ChrGri/DIY-Sim-Racing-FFB-BeltTensioner/docs/media/youtube_thumbnail_1.jpg

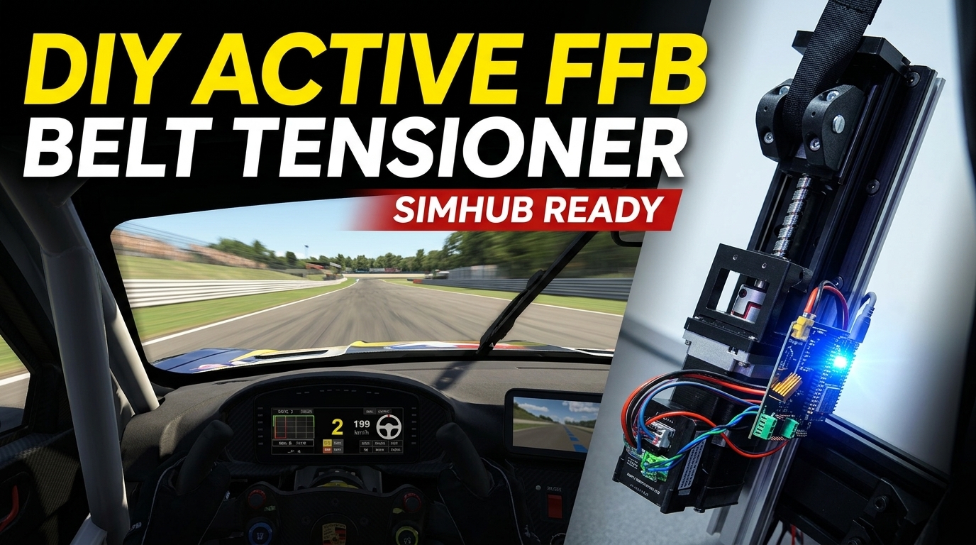
docs/media/youtube_thumbnail_1.jpg
