ChrGri/DIY-Sim-Racing-FFB-BeltTensioner/docs/media/youtube_thumbnail_2.jpg

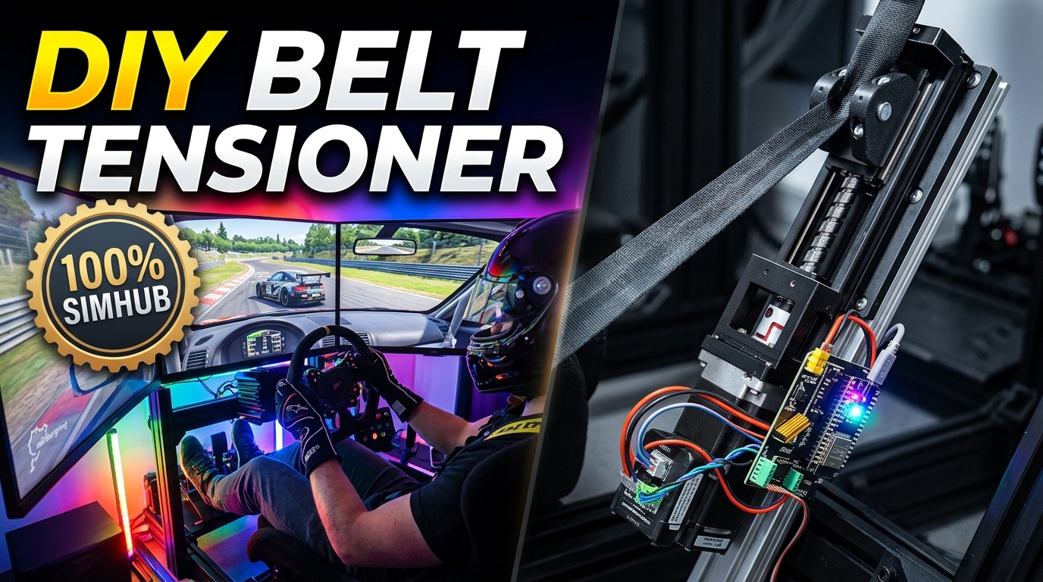
docs/media/youtube_thumbnail_2.jpg
