ChrGri/DIY-Sim-Racing-FFB-BeltTensioner/cad/models/ControlBoard_PCB_V8.step

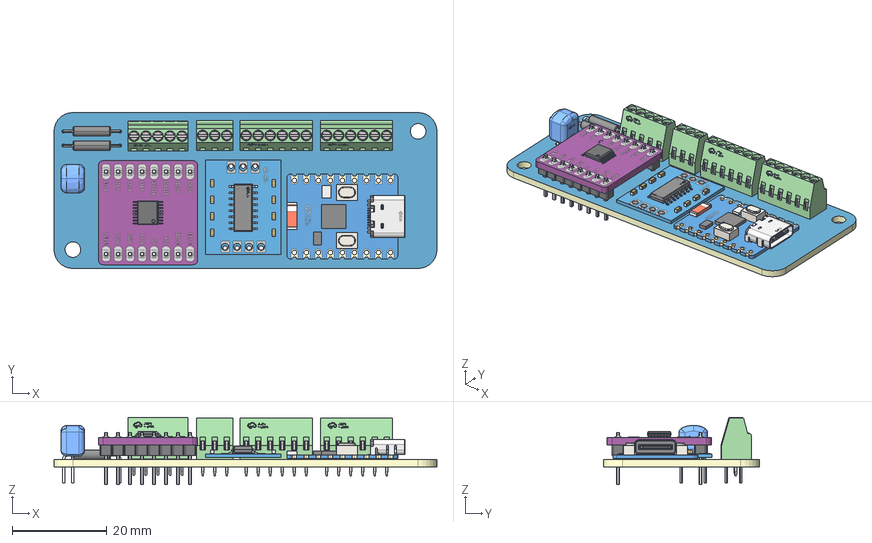
[picture p10: CAD file, 2026-11-06]
cad/models/ControlBoard_PCB_V8.step
81.0 x 33.0 x 14.2 mm
Board~VP4O
TopCopper~VP4O
BottomCopper~VP4O
TopSilkscreen~VP4O
BottomSilkscreen~VP4O
TopFpcStiffener~VP4O
BottomFpcStiffener~VP4O
R0402~R0402_L1.0-W0.5-H0.4~fqwY
CONN-TH_3P-P2.54_KF128-2.54-3P~CONN-TH_3P-P2.54_KF128-2.54-3P~D9WB
RES-TH_BD2.0-L7.9-P11.90-D0.5~RES-TH_BD2.0-L7.9-P11.90-D0.5~TKbl x 2
COMM-SMD_18P-P2.54-L23.5-W18.0-TL~COMM-SMD_18P-P2.54-L23.5-W18.0-TL~Zh6c
CONN-TH_5P-P2.54_KF128-2.54-5P~CONN-TH_5P-P2.54_KF128-2.54-5P~VWN4
CAP-TH_L6.0-W5.0-P5.08-D0.5~CAP-TH_L6.0-W5.0-P5.08-D0.5~rwA4
ADS1220 24 Bit ADC Converter Module~ADS1220_module2.step~r0Ls x 2
CONN-TH_6P-P2.54_KF128-2.54-6P~CONN-TH_6P-P2.54_KF128-2.54-6P~9kNG x 2
TTL-RS232-SP3232~COMM-TH_SP3232~yDeD x 10
