ChrGri/DIY-Sim-Racing-FFB-BeltTensioner/cad/stl/PCB_Halter_1x.3mf

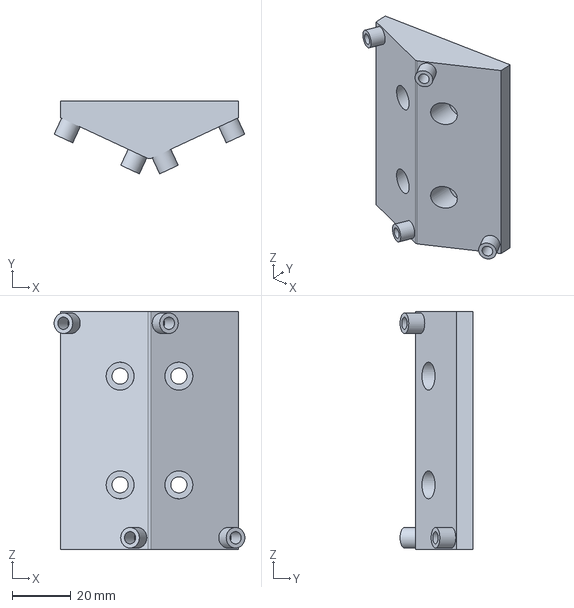
[picture p11: CAD file, 2026-11-06]
cad/stl/PCB_Halter_1x.3mf
64.9 x 24.8 x 81.0 mm
