ChrGri/DIY-Sim-Racing-FFB-BeltTensioner/cad/models/Untitled.step

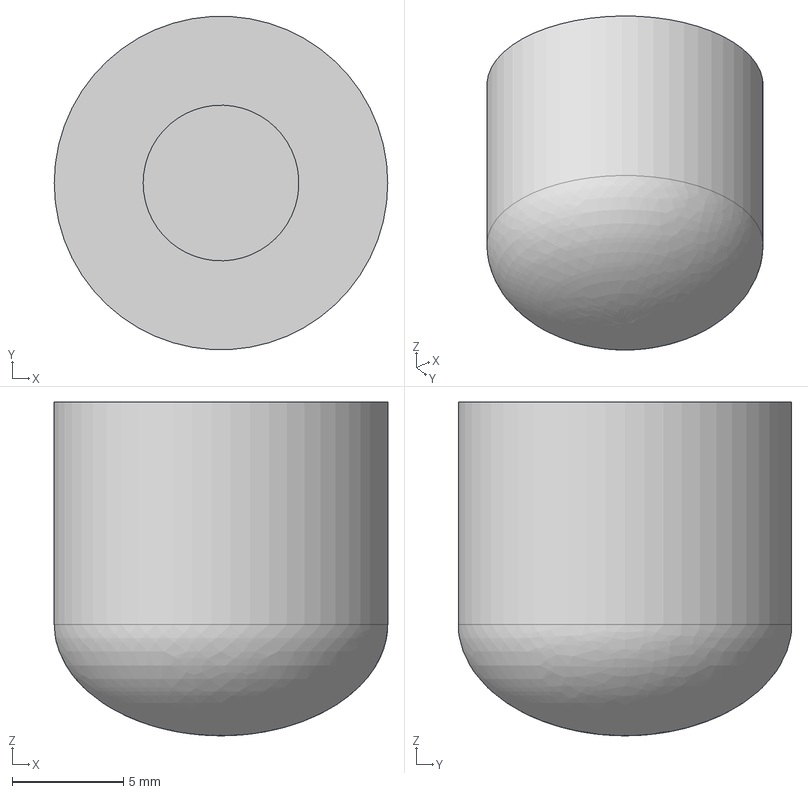
[picture p12: CAD file, 2026-10-21]
cad/models/Untitled.step
15.0 x 15.0 x 15.0 mm
