ChrGri/DIY-Sim-Racing-FFB-BeltTensioner/cad/stl/Haube_oben_links_1x.3mf

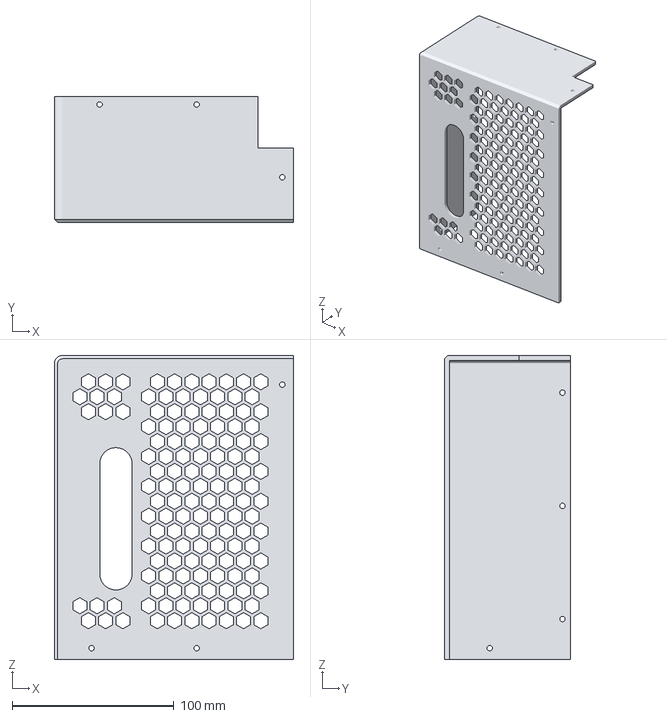
[picture p13: CAD file, 2026-11-06]
cad/stl/Haube_oben_links_1x.3mf
148.0 x 78.0 x 188.0 mm
