ChrGri/DIY-Sim-Racing-FFB-BeltTensioner/cad/models/4020_connector.step

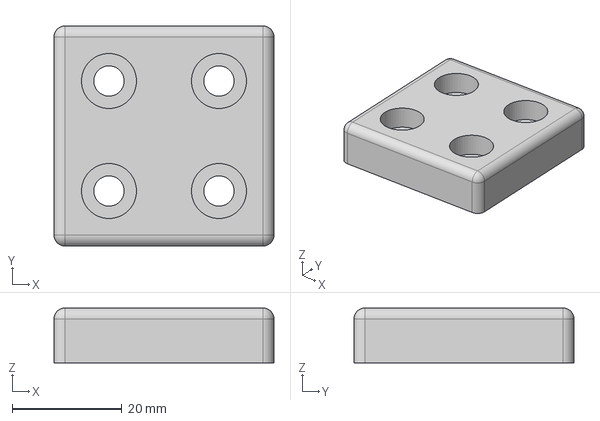
[picture p14: CAD file, 2026-10-21]
cad/models/4020_connector.step
40.0 x 40.0 x 10.0 mm
