ChrGri/DIY-Sim-Racing-FFB-BeltTensioner/cad/stl/Distanzhuelse_M8_15mm_2x.3mf

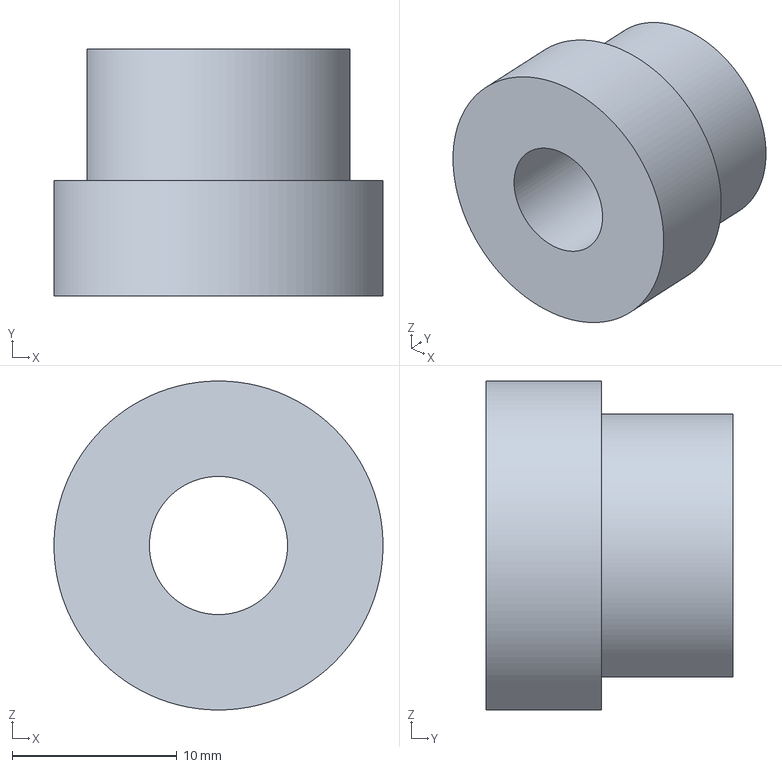
[picture p15: CAD file, 2026-11-06]
cad/stl/Distanzhuelse_M8_15mm_2x.3mf
20.0 x 15.0 x 20.0 mm
