ChrGri/DIY-Sim-Racing-FFB-BeltTensioner/cad/stl/Haube_oben_rechts_1x.3mf

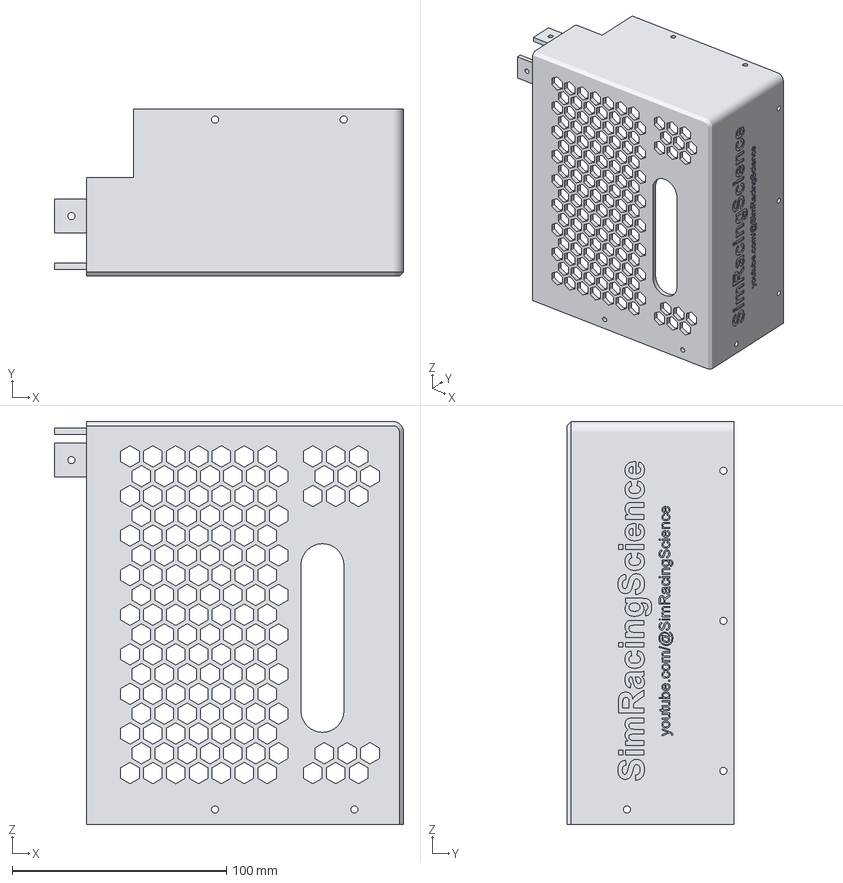
[picture p16: CAD file, 2026-11-06]
cad/stl/Haube_oben_rechts_1x.3mf
163.0 x 78.0 x 188.0 mm
