ChrGri/DIY-Sim-Racing-FFB-BeltTensioner/cad/stl/Rueckplatte_unten_links_1x.3mf

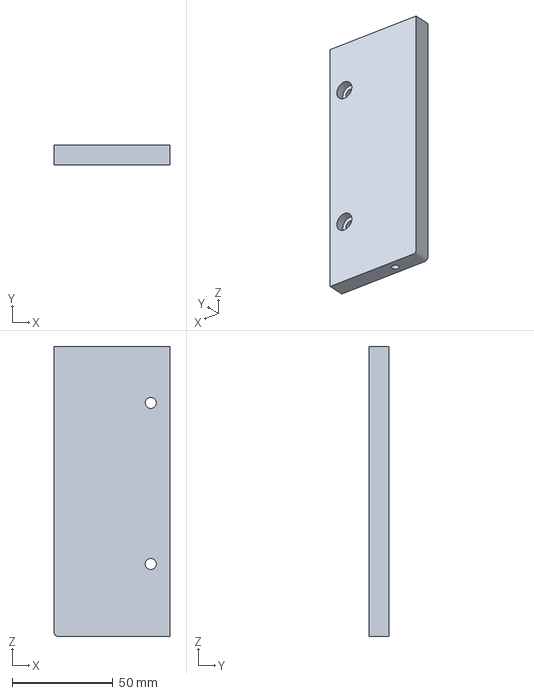
[picture p17: CAD file, 2026-10-24]
cad/stl/Rueckplatte_unten_links_1x.3mf
57.5 x 10.0 x 144.0 mm
