ChrGri/DIY-Sim-Racing-FFB-BeltTensioner/cad/stl/Haube_unten_links_1x.3mf

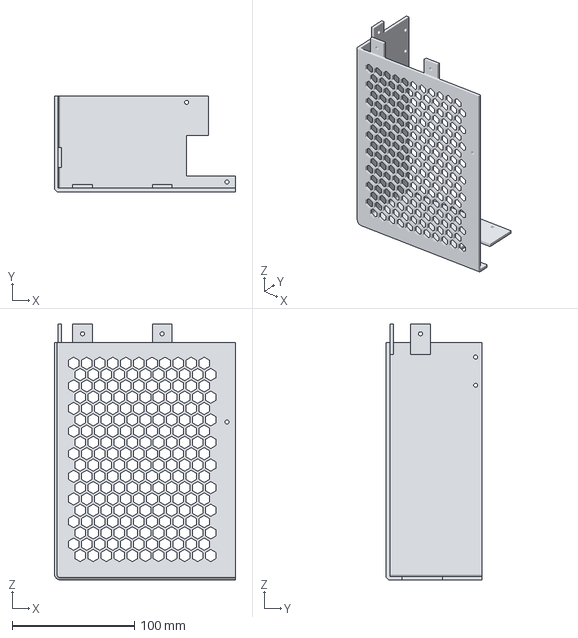
[picture p18: CAD file, 2026-10-24]
cad/stl/Haube_unten_links_1x.3mf
148.0 x 78.0 x 209.0 mm
