ChrGri/DIY-Sim-Racing-FFB-BeltTensioner/cad/stl/Haube_unten_rechts_1x.3mf

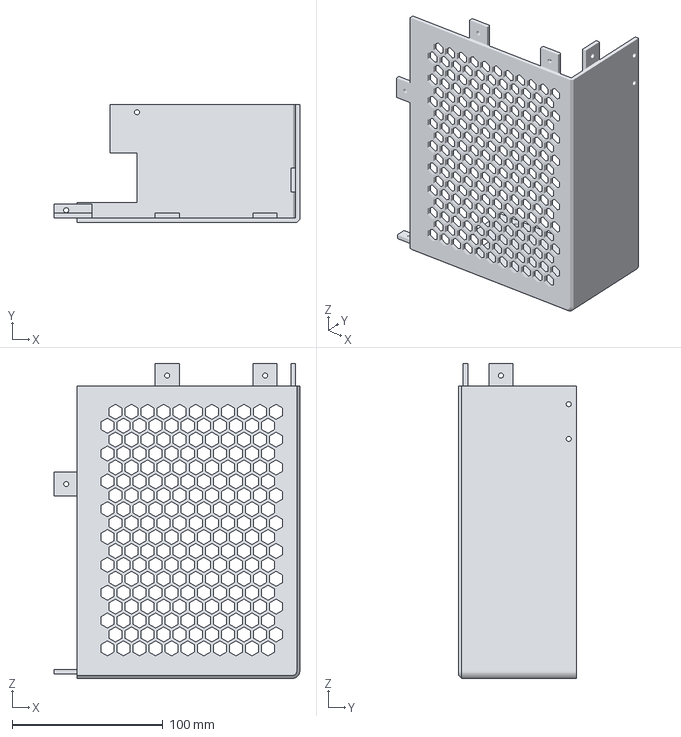
[picture p19: CAD file, 2026-10-24]
cad/stl/Haube_unten_rechts_1x.3mf
163.0 x 78.0 x 209.0 mm
