ChrGri/DIY-Sim-Racing-FFB-BeltTensioner/cad/stl/Rueckplatte_oben_links_1x.3mf

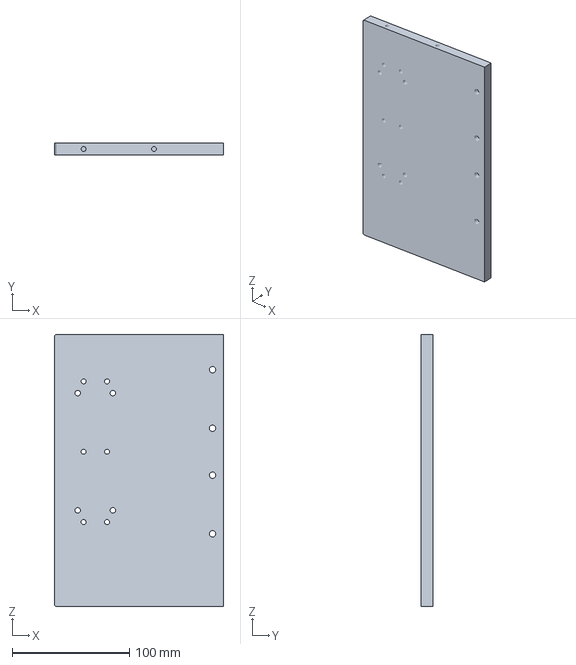
[picture p20: CAD file, 2026-10-21]
cad/stl/Rueckplatte_oben_links_1x.3mf
144.5 x 10.0 x 232.0 mm
