ChrGri/DIY-Sim-Racing-FFB-BeltTensioner/cad/stl/RollerAdapter_4x.3mf

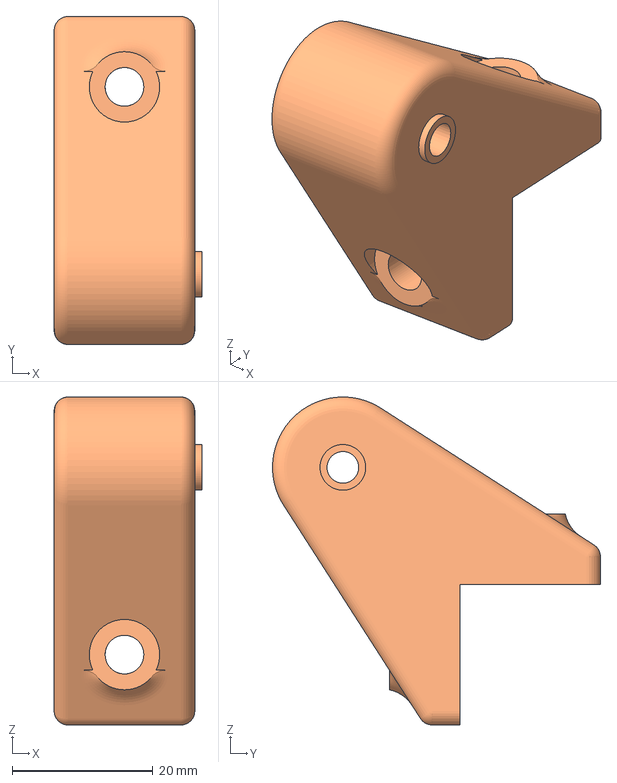
[picture p21: CAD file, 2026-10-21]
cad/stl/RollerAdapter_4x.3mf
21.0 x 46.6 x 46.6 mm
