ChrGri/DIY-Sim-Racing-FFB-BeltTensioner/cad/stl/BeltRoller_2x.3mf

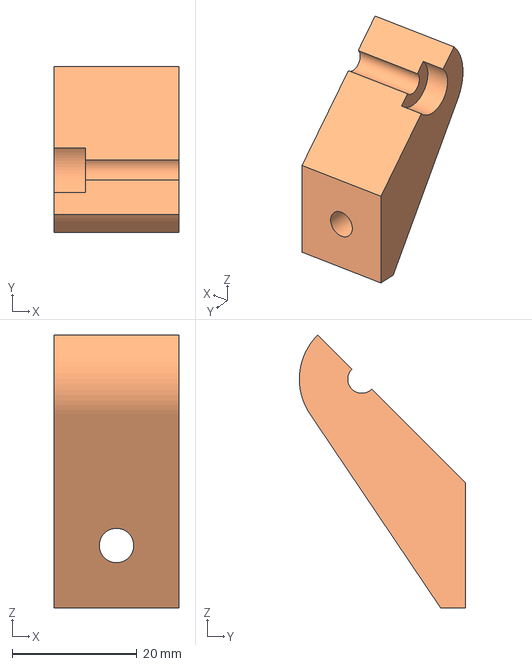
[picture p22: CAD file, 2026-10-21]
cad/stl/BeltRoller_2x.3mf
20.0 x 26.6 x 43.7 mm
