ChrGri/DIY-Sim-Racing-FFB-BeltTensioner/(list of files, cad)

Other CAD files:
cad/stl/Rueckplatte_unten_rechts_1x.3mf
cad/stl/Rueckplatte_oben_rechts_1x.3mf
cad/models/BeltRoller.f3d
cad/models/M8_bolt_damper.f3d
