ChrGri/DIY-Sim-Racing-FFB-BeltTensioner/docs/Developer_Guide.md

# Developer & Hardware Configuration Guide

This guide covers hardware pinouts, board configurations, firmware parameters in `src/Config.h`, and building/compiling the firmware from source using PlatformIO.

---

## 🔌 Hardware Setup & Pinouts

### ControlBoard_V6 (ESP32-S3 DevKit)

| Function | ESP32-S3 Pin | Note |
| :--- | :--- | :--- |
| **Actuator 1 STEP (PUL+)** | `GPIO 37` | Hardware pulse output |
| **Actuator 1 DIR (DIR+)** | `GPIO 36` | Direction signal (`INVERT_DIR = true`) |
| **Actuator 1 Modbus RX** | `GPIO 1` | RS232 Receive from iSV57 |
| **Actuator 1 Modbus TX** | `GPIO 2` | RS232 Transmit to iSV57 |
| **Actuator 1 Alarm (ALM)** | `GPIO 11` | Servo fault detection |
| **Actuator 1 Brake Resistor** | `GPIO 35` | Optional brake chopper control |
| **USB Serial** | `CP2102 UART0` | SimHub connection (`250000` baud) |

### ControlBoard_V7 (ESP32-S3-Zero)

| Function | ESP32-S3 Pin | Note |
| :--- | :--- | :--- |
| **Actuator 1 STEP (PUL+)** | `GPIO 4` | Hardware pulse output |
| **Actuator 1 DIR (DIR+)** | `GPIO 5` | Direction signal |
| **Actuator 1 Modbus RX** | `GPIO 3` | RS232 Receive |
| **Actuator 1 Modbus TX** | `GPIO 2` | RS232 Transmit |

### ControlBoard_V8 (ESP32-S3-Zero)

| Function | ESP32-S3 Pin | Note |
| :--- | :--- | :--- |
| **Actuator 1 STEP (PUL+)** | `GPIO 4` | Hardware pulse output |
| **Actuator 1 DIR (DIR+)** | `GPIO 3` | Direction signal |
| **Actuator 1 Modbus RX** | `GPIO 6` | RS232 Receive (via SP3232) |
| **Actuator 1 Modbus TX** | `GPIO 5` | RS232 Transmit (via SP3232) |
| **Actuator 1 Alarm (ALM)** | `GPIO 2` | Servo fault detection |
| **Status RGB LED** | `GPIO 21` | On-board WS2812B NeoPixel |

### ControlBoard_PCBA_V2X (LOLIN S3 Mini)

| Function | ESP32-S3 Pin | Note |
| :--- | :--- | :--- |
| **Actuator 1 STEP (PUL+)** | `GPIO 38` | Hardware pulse output |
| **Actuator 1 DIR (DIR+)** | `GPIO 37` | Direction signal |
| **Actuator 1 Modbus RX** | `GPIO 9` | RS232 Receive |
| **Actuator 1 Modbus TX** | `GPIO 10` | RS232 Transmit |
| **Actuator 1 Brake Resistor** | `GPIO 4` | Brake resistor chopper control |
| **Servo Power Switch** | `GPIO 3` | MOSFET power switch (driven HIGH at boot) |
| **Status RGB LED** | `GPIO 12` | On-board WS2812B NeoPixel |

### ControlBoard_V4 (ESP32-S3 DevKit)

| Function | ESP32-S3 Pin | Note |
| :--- | :--- | :--- |
| **Actuator 1 STEP (PUL+)** | `GPIO 38` | Hardware pulse output |
| **Actuator 1 DIR (DIR+)** | `GPIO 37` | Direction signal |
| **Actuator 1 Modbus RX** | `GPIO 9` | RS232 Receive (inverted UART signal) |
| **Actuator 1 Modbus TX** | `GPIO 10` | RS232 Transmit (inverted UART signal) |
| **USB Serial** | `CP2102 UART0` | SimHub connection (`250000` baud) |

### ControlBoard_V5 (ESP32-S3 DevKit)

| Function | ESP32-S3 Pin | Note |
| :--- | :--- | :--- |
| **Actuator 1 STEP (PUL+)** | `GPIO 37` | Hardware pulse output |
| **Actuator 1 DIR (DIR+)** | `GPIO 36` | Direction signal |
| **Actuator 1 Modbus RX** | `GPIO 1` | RS232 Receive |
| **Actuator 1 Modbus TX** | `GPIO 2` | RS232 Transmit |
| **Actuator 1 Brake Resistor** | `GPIO 35` | Brake resistor chopper control |
| **Status RGB LED** | `GPIO 38` | On-board WS2812B NeoPixel |
| **USB Serial** | `CP2102 UART0` | SimHub connection (`250000` baud) |

### ControlBoard_PCBA_V1X (ESP32-S3, native USB)

| Function | ESP32-S3 Pin | Note |
| :--- | :--- | :--- |
| **Actuator 1 STEP (PUL+)** | `GPIO 38` | Hardware pulse output |
| **Actuator 1 DIR (DIR+)** | `GPIO 37` | Direction signal |
| **Actuator 1 Modbus RX** | `GPIO 9` | RS232 Receive (inverted UART signal) |
| **Actuator 1 Modbus TX** | `GPIO 10` | RS232 Transmit (inverted UART signal) |
| **Status RGB LED** | `GPIO 12` | On-board WS2812B NeoPixel |
| **USB Serial** | `Native USB CDC` | SimHub connection |

### 🛠️ Soldering & PCB Assembly

Follow the dedicated step-by-step soldering tutorial:  
👉 **[Control PCB Assembly & Soldering Guide](PCB_Assembly.md)**

**Belt Tensioner Specific Simplifications:**
* **Power Circuit:** Populate only the **SR5100 diode** and the **XT30 power connector**. The MOSFET and brake resistor circuit are **not needed**.
* **Loadcell Circuit:** Do **not** solder the ADS1220 ADC or RC filter network (no loadcell is used).
* **Connections:** Only the **RS232** (Modbus telemetry) and **PUL / DIR / ALM** servo interface lines are required.

---

## ⚙️ Firmware Configuration (`src/Config.h`)

All user-configurable mechanical, motion scaling, and safety parameters can be customized in [`src/Config.h`](../src/Config.h):

```c
// Stroke length and motor mechanics
#define NUM_ACTUATORS                 1       // 1 = Mono tensioner, 2 = Dual (Left + Right)
#define STEPS_PER_MOTOR_REV           3200U   // iSV57 microsteps per revolution
#define SPINDLE_PITCH_MM              10.0f   // Lead screw pitch (mm per rev), default - per axis via SET_PITCH
#define TOTAL_WORKING_RANGE_MM        50.0f   // Usable stroke distance on rail, default - per axis via SET_RANGE

// Motion in carriage units, converted per axis with its own pitch
#define MAX_STEP_RATE_HZ              190000U   // Pulse generator limit per axis (< 200 kHz FastAccelStepper limit)
#define DEFAULT_MAX_SPEED_M_S         0.296875f // = 190 kHz at 5 mm pitch (95 kHz at 10 mm)
#define DEFAULT_ACCELERATION_M_S2     9.375f    // = 6.0M steps/s^2 at 5 mm pitch

// Dynamic Multipliers for SimHub UI Sliders
#define SPEED_MULTIPLIER              (DEFAULT_MAX_SPEED_M_S / 36000.0f)       // Scales 36k -> 0.297 m/s
#define ACCELERATION_MULTIPLIER       (DEFAULT_ACCELERATION_M_S2 / 100000.0f)  // Scales 100k -> 9.375 m/s^2

// Tension Direction (false = 0% loose / 100% pull tight on braking)
#define INVERT_TENSION_DIRECTION      false

// Sensorless Homing (false = single-endstop homing, true = dual-endstop stroke measurement)
#define MEASURE_MAX_TRAVEL_SENSORLESS false
#define HOMING_CURRENT_THRESHOLD_PCT  15      // Servo current % threshold for endstop contact
```

---

## 💻 Compiling & Flashing from Source (PlatformIO)

If you want to modify code, add custom features, or build locally:

### 1. Prerequisites
* [VS Code](https://code.visualstudio.com/)
* [PlatformIO IDE Extension](https://platformio.org/install/ide?install=vscode)

### 2. Clone the Repository
```bash
git clone https://github.com/ChrGri/DIY-Sim-Racing-FFB-BeltTensioner.git
```

### 3. Open and Build in PlatformIO
1. Open the cloned folder in **VS Code**.
2. Select your environment from the PlatformIO status bar:
   * `ControlBoard_V6` for ESP32-S3 DevKit
   * `ControlBoard_V7` for ControlBoard_V7 (ESP32-S3-Zero)
   * `ControlBoard_V8` for ControlBoard_V8 (ESP32-S3-Zero)
   * `ControlBoard_PCBA_V2X_without_espnow` for ControlBoard PCBA V2.x (LOLIN S3 Mini)
   * `ControlBoard_PCBA_V1X` for ControlBoard PCBA V1.x
   * `ControlBoard_V5_without_espnow` for ControlBoard_V5 (ESP32-S3 DevKit)
   * `ControlBoard_V4` for ControlBoard_V4 (ESP32-S3 DevKit)
   * `esp32_devkit` for ESP32 DevKit v1
3. Connect your board via USB and click **Upload** (or run):
   ```powershell
   pio run -e ControlBoard_V6 -t upload
   ```
