ChrGri/DIY-Sim-Racing-FFB-BeltTensioner/src/main.cpp

#include <Arduino.h>
#include <FastAccelStepper.h>
#include "Config.h"
#include "AxisUnit.h"
#include "BeltTensionerProtocol.h"
#include "HostSerial.h"
#include "StatusLed.h"
#include "WebGraphs.h"

// Stepper engine instance (hardware RMT / MCPWM pulse generator)
FastAccelStepperEngine engine = FastAccelStepperEngine();

// Actuator units
AxisUnit axisUnit1;
#if (NUM_ACTUATORS >= 2)
AxisUnit axisUnit2;
#endif

// Array of active axis units
AxisUnit* axisUnits[] = {
    &axisUnit1
#if (NUM_ACTUATORS >= 2)
    , &axisUnit2
#endif
};
const uint8_t axisCount = sizeof(axisUnits) / sizeof(AxisUnit*);

// SimHub protocol handler
BeltTensionerProtocol protocol;

// Status RGB LED (Waveshare ESP32-S3 WS2812)
StatusLed statusLed;

// FreeRTOS Task handle for background Modbus telemetry polling
TaskHandle_t taskModbusTelemetryHandle = nullptr;

// Background task running on Core 0 to continuously poll iSV57 servo telemetry
void modbusTelemetryTask(void* pvParameters) {
    while (true) {
        for (uint8_t i = 0; i < axisCount; i++) {
            if (axisUnits[i] != nullptr) {
                axisUnits[i]->pollModbusTelemetry();
            }
        }
        // Feed the live web graphs (no-op if disabled)
        webGraphs.recordSample();
        vTaskDelay(pdMS_TO_TICKS(MODBUS_POLL_INTERVAL_MS));
    }
}

void setup() {
    // 0. Enable hardware servo power rail if supported by board
#ifdef SERVO_POWER_PIN
    if (SERVO_POWER_PIN >= 0) {
        pinMode(SERVO_POWER_PIN, OUTPUT);
        digitalWrite(SERVO_POWER_PIN, HIGH);
    }
#endif

    // 1. Immediately clamp all control & communication pins to prevent floating state / glitches
    if (ACTUATOR1_BRAKE_RESISTOR_PIN >= 0) {
        pinMode(ACTUATOR1_BRAKE_RESISTOR_PIN, OUTPUT);
        digitalWrite(ACTUATOR1_BRAKE_RESISTOR_PIN, LOW);
    }
    if (ACTUATOR1_MODBUS_TX_PIN >= 0) {
        pinMode(ACTUATOR1_MODBUS_TX_PIN, OUTPUT);
        digitalWrite(ACTUATOR1_MODBUS_TX_PIN, ACTUATOR1_MODBUS_INVERT ? LOW : HIGH);
    }
    if (ACTUATOR1_STEP_PIN >= 0) {
        pinMode(ACTUATOR1_STEP_PIN, OUTPUT);
        digitalWrite(ACTUATOR1_STEP_PIN, LOW);
    }
    if (ACTUATOR1_DIR_PIN >= 0) {
        pinMode(ACTUATOR1_DIR_PIN, OUTPUT);
        digitalWrite(ACTUATOR1_DIR_PIN, LOW);
    }
    if (ACTUATOR1_ENA_PIN >= 0) {
        pinMode(ACTUATOR1_ENA_PIN, OUTPUT);
        digitalWrite(ACTUATOR1_ENA_PIN, LOW);
    }
#if (NUM_ACTUATORS >= 2)
    if (ACTUATOR2_BRAKE_RESISTOR_PIN >= 0) {
        pinMode(ACTUATOR2_BRAKE_RESISTOR_PIN, OUTPUT);
        digitalWrite(ACTUATOR2_BRAKE_RESISTOR_PIN, LOW);
    }
    if (ACTUATOR2_MODBUS_TX_PIN >= 0) {
        pinMode(ACTUATOR2_MODBUS_TX_PIN, OUTPUT);
        digitalWrite(ACTUATOR2_MODBUS_TX_PIN, ACTUATOR2_MODBUS_INVERT ? LOW : HIGH);
    }
    if (ACTUATOR2_STEP_PIN >= 0) {
        pinMode(ACTUATOR2_STEP_PIN, OUTPUT);
        digitalWrite(ACTUATOR2_STEP_PIN, LOW);
    }
    if (ACTUATOR2_DIR_PIN >= 0) {
        pinMode(ACTUATOR2_DIR_PIN, OUTPUT);
        digitalWrite(ACTUATOR2_DIR_PIN, LOW);
    }
    if (ACTUATOR2_ENA_PIN >= 0) {
        pinMode(ACTUATOR2_ENA_PIN, OUTPUT);
        digitalWrite(ACTUATOR2_ENA_PIN, LOW);
    }
#endif

    // 2. Initialize Host PC Serial for SimHub communication & serial monitor logging
    Serial.setRxBufferSize(128);
    Serial.begin(SIMHUB_SERIAL_BAUDRATE);
    protocol.begin(axisUnits, axisCount);
    webGraphs.begin(axisUnits, axisCount);

    // SimHub BeltTensioner boot greeting
    protocol.sendGreeting(&Serial);

    // 3. Initialize FastAccelStepper pulse generator engine
    engine.init();

    // 4. Configure and initialize Actuator 1
    // Spindle pitch & working range come from NVS or Config.h; speeds are in m/s,
    // so axes with different pitches move identically.
    AxisMechConfig mech1 = AxisConfig::load(0);
    AxisUnitSettings settings1;
    settings1.stepperId               = 1;
    settings1.stepPin                 = ACTUATOR1_STEP_PIN;
    settings1.dirPin                  = ACTUATOR1_DIR_PIN;
    settings1.enaPin                  = ACTUATOR1_ENA_PIN;
    settings1.almPin                  = ACTUATOR1_ALM_PIN;
    settings1.brakeResistorPin        = ACTUATOR1_BRAKE_RESISTOR_PIN;
    settings1.invertDir               = ACTUATOR1_INVERT_DIR;
    settings1.invertTensionDir        = INVERT_TENSION_DIRECTION;
    settings1.mech                    = mech1;
    settings1.totalWorkingRange       = mech1.workingRangeSteps();
    settings1.maxSpeedMS              = DEFAULT_MAX_SPEED_M_S;
    settings1.accelerationMS2         = DEFAULT_ACCELERATION_M_S2;
    settings1.homingCurrentThreshold  = HOMING_CURRENT_THRESHOLD_PCT;
    settings1.homingSpeedMS           = HOMING_SPEED_M_S;
    settings1.homingAccelMS2          = HOMING_ACCELERATION_M_S2;
    settings1.centerAfterCalib        = CENTER_AFTER_CALIBRATION;
    settings1.homingBackoffMm         = HOMING_BACKOFF_MM;
    settings1.measureMaxTravel        = MEASURE_MAX_TRAVEL_SENSORLESS;

    axisUnit1.begin(&engine,
                    settings1,
                    &Serial2,
                    ACTUATOR1_MODBUS_RX_PIN,
                    ACTUATOR1_MODBUS_TX_PIN,
                    ACTUATOR1_MODBUS_SLAVE_ID,
                    CALIBRATE_AT_BOOT,
                    ACTUATOR1_MODBUS_INVERT);

    // 5. Configure and initialize Actuator 2 (if enabled)
#if (NUM_ACTUATORS >= 2)
    AxisMechConfig mech2 = AxisConfig::load(1);
    AxisUnitSettings settings2;
    settings2.stepperId               = 2;
    settings2.stepPin                 = ACTUATOR2_STEP_PIN;
    settings2.dirPin                  = ACTUATOR2_DIR_PIN;
    settings2.enaPin                  = ACTUATOR2_ENA_PIN;
    settings2.almPin                  = ACTUATOR2_ALM_PIN;
    settings2.brakeResistorPin        = ACTUATOR2_BRAKE_RESISTOR_PIN;
    settings2.invertDir               = ACTUATOR2_INVERT_DIR;
    settings2.invertTensionDir        = INVERT_TENSION_DIRECTION;
    settings2.mech                    = mech2;
    settings2.totalWorkingRange       = mech2.workingRangeSteps();
    settings2.maxSpeedMS              = DEFAULT_MAX_SPEED_M_S;
    settings2.accelerationMS2         = DEFAULT_ACCELERATION_M_S2;
    settings2.homingCurrentThreshold  = HOMING_CURRENT_THRESHOLD_PCT;
    settings2.homingSpeedMS           = HOMING_SPEED_M_S;
    settings2.homingAccelMS2          = HOMING_ACCELERATION_M_S2;
    settings2.centerAfterCalib        = CENTER_AFTER_CALIBRATION;
    settings2.homingBackoffMm         = HOMING_BACKOFF_MM;
    settings2.measureMaxTravel        = MEASURE_MAX_TRAVEL_SENSORLESS;

    axisUnit2.begin(&engine,
                    settings2,
                    &Serial1,
                    ACTUATOR2_MODBUS_RX_PIN,
                    ACTUATOR2_MODBUS_TX_PIN,
                    ACTUATOR2_MODBUS_SLAVE_ID,
                    CALIBRATE_AT_BOOT,
                    ACTUATOR2_MODBUS_INVERT);
#endif

    // 6. Launch FreeRTOS background task on Core 0 for Modbus telemetry & stall monitoring
    xTaskCreatePinnedToCore(
        modbusTelemetryTask,
        "modbusTask",
        4096,
        nullptr,
        1,
        &taskModbusTelemetryHandle,
        TASK_CORE_MODBUS_TELEMETRY
    );

    // 7. Initialize on-board RGB Status LED (WS2812)
    statusLed.begin(RGB_LED_GPIO, RGB_LED_BRIGHTNESS);

    // 8. Start WiFi + live web graphs (if enabled in Config.h).
    // Runs silently: any extra text line on Serial would break the SimHub handshake
    // (SimHub parses the reply to CMD 10 as "Enabled motors:<N>"). Use WEBGRAPHS to print the address.
#if ENABLE_WEBGRAPHS
    webGraphs.activate();
#endif
}

void loop() {
    // 1. Process incoming SimHub commands on USB serial
    protocol.processIncomingStream(&hostSerial);
    if (hostGreetingDue()) {
        protocol.sendGreeting(&hostSerial);
    }

    // 2. Update sensorless homing and idle parking watchdogs
    for (uint8_t i = 0; i < axisCount; i++) {
        if (axisUnits[i] != nullptr) {
            axisUnits[i]->updateIdleWatchdog(IDLE_DELAY_MS);
        }
    }

    // 3. Update status RGB LED color based on system state
    statusLed.update(axisUnits, axisCount);

    // 4. Yield CPU to prevent Task Watchdog (TWDT) reset on Core 1
    yield();
}
