ChrGri/DIY-Sim-Racing-FFB-BeltTensioner/src/AxisUnit.cpp

#include "AxisUnit.h"

AxisUnit::AxisUnit() {
    state.motorPowered = false;
    state.motorReady = false;
    state.targetPosition = -1;
    state.lastActivityTime = 0;
    state.firstActivityTime = 0;
    state.isParked = false;
    state.finalVelocityApplied = false;
    state.homingState = HOMING_IDLE;
    hardLimitMin = 0;
    hardLimitMax = TOTAL_WORKING_RANGE_STEPS;
    servo_offset_compensation_steps_i32 = 0;
    servoPosCorrected_i32 = 0;
}

void AxisUnit::log(const String& msg) {
    Serial.print(logHeader);
    Serial.println(msg);
}

uint32_t AxisUnit::toStepRate(float metersPerSecond) const {
    return (uint32_t)(metersPerSecond * 1000.0f * settings.mech.stepsPerMm());
}

void AxisUnit::applyMotionUnits() {
    // Clamp only protects the pulse generator for pitches finer than 5 mm
    uint32_t speedHz = toStepRate(settings.maxSpeedMS);
    settings.maxSpeed = (speedHz > MAX_STEP_RATE_HZ) ? MAX_STEP_RATE_HZ : speedHz;
    settings.acceleration = toStepRate(settings.accelerationMS2);
    settings.homingSpeed = toStepRate(settings.homingSpeedMS);
    settings.homingAccel = toStepRate(settings.homingAccelMS2);
    settings.homingBackoffSteps = (int32_t)(settings.homingBackoffMm * settings.mech.stepsPerMm());
    settings.homingMinTravelSteps = (int32_t)(HOMING_MIN_TRAVEL_MM * settings.mech.stepsPerMm());
}

bool AxisUnit::begin(FastAccelStepperEngine* engine,
                     const AxisUnitSettings& axisSettings,
                     HardwareSerial* serial,
                     int8_t rxPin,
                     int8_t txPin,
                     int16_t slaveId,
                     bool calibrateAtBoot,
                     bool invertModbusSignal) {
    settings = axisSettings;
    applyMotionUnits();
    logHeader = "M" + String(settings.stepperId) + " ";
    hardLimitMax = settings.totalWorkingRange;

    if (settings.brakeResistorPin >= 0) {
        pinMode(settings.brakeResistorPin, OUTPUT);
        digitalWrite(settings.brakeResistorPin, LOW);
    }

    if (txPin >= 0) {
        // UART idle level: HIGH for normal, LOW for inverted signal
        pinMode(txPin, OUTPUT);
        digitalWrite(txPin, invertModbusSignal ? LOW : HIGH);
    }

    // 1. Initialize Modbus communication structure (asynchronous discovery in Core 0 task)
    isv57.setSerial(serial, slaveId);
    isv57.initialize(ISV57_MODBUS_BAUDRATE, rxPin, txPin, invertModbusSignal);
    servoInitialized = false;

    state.motorPowered = calibrateAtBoot;
    state.motorReady = false;
    state.lastActivityTime = millis();
    state.isParked = false;

    // 2. Initialize FastAccelStepper pulse generator
    if (engine != nullptr && settings.stepPin >= 0) {
        stepper = engine->stepperConnectToPin(settings.stepPin);
        if (stepper != nullptr) {
            if (settings.dirPin >= 0) {
                stepper->setDirectionPin(settings.dirPin, settings.invertDir);
            }
            if (settings.enaPin >= 0) {
                stepper->setEnablePin(settings.enaPin, true);
                if (calibrateAtBoot) {
                    stepper->enableOutputs();
                } else {
                    stepper->disableOutputs();
                }
            }
            stepper->setSpeedInHz(settings.maxSpeed);
            stepper->setAcceleration(settings.acceleration);
            stepper->applySpeedAcceleration();
            stepper->setCurrentPosition(0);
        }
    }

    if (calibrateAtBoot) {
        startSensorlessHoming();
    } else {
        state.homingState = HOMING_IDLE;
        state.motorReady = false;
    }

    return (stepper != nullptr);
}

void AxisUnit::pollModbusTelemetry() {
    if (isFlashing || isReadingParams) return;

    // 1. Asynchronously connect to servo in background without blocking SimHub communication
    if (!servoInitialized) {
        if (isv57.findServosSlaveId()) {
            isv57.clearServoAlarms();
            isv57.readMotorRatings(); // Keeps the table defaults if the read fails
            isv57.setupServoStateReading();
            if (state.motorPowered) {
                isv57.enableAxis();
            } else {
                isv57.disableAxis();
            }
            isv57.readServoStates();
            if (isv57.dynamicStates.servo_receivedPacketIsValid_b) {
                servoInitialized = true;
            }
        }
        return;
    }

    // 2. Cyclic telemetry read
    isv57.readServoStates();

    // 3. If telemetry packet is valid and axis is homed, calculate step loss offset
    if (isv57.dynamicStates.servo_receivedPacketIsValid_b && state.homingState == HOMING_DONE) {
        unwrapAndCalculateStepLoss();
    }
}

void AxisUnit::unwrapAndCalculateStepLoss() {
    int32_t rawServoPos = (int32_t)isv57.getPosFromMin();

    // Invert reading if motor direction is inverted
    if (settings.invertDir) {
        rawServoPos *= -1;
    }

    int32_t espPos = (stepper != nullptr) ? stepper->getCurrentPosition() : 0;
    int32_t posDiff = espPos - rawServoPos;

    // Handle 16-bit encoder wrap-arounds (overflow / underflow)
    int32_t wraps = 0;
    if (posDiff > 32767) {
        wraps = (posDiff + 32768) / 65536;
    } else if (posDiff < -32768) {
        wraps = (posDiff - 32767) / 65536;
    }

    servoPosCorrected_i32 = rawServoPos + (wraps * 65536);

    if (settings.enableStepLossRecov) {
        // Step loss offset = ESP's step count - Servo's true optical encoder position
        int32_t servo_offset_compensation_steps_local = espPos - servoPosCorrected_i32;

        // Lockless 32-bit atomic assignment on ESP32-S3
        servo_offset_compensation_steps_i32 = servo_offset_compensation_steps_local;
    }
}

void AxisUnit::correctPos() {
    if (stepper == nullptr || !settings.enableStepLossRecov) return;

    // Only apply correction when motor is idle/standstill
    if (stepper->isRunning()) return;

    // Read offset lockless
    int32_t offset = servo_offset_compensation_steps_i32;

    // If offset exceeds threshold (e.g. 5 steps), smoothly correct ESP position register
    if (abs(offset) > 5) {
        int32_t currentPos = stepper->getCurrentPosition();
        stepper->setCurrentPosition(currentPos - offset);
        servo_offset_compensation_steps_i32 = 0;
    }
}

void AxisUnit::printStatus() {
    // Reserved for diagnostic printing
}

bool AxisUnit::enableMotor() {
    if (!state.motorPowered) {
        if (stepper != nullptr) {
            stepper->enableOutputs();
        }
        isv57.enableAxis();
        state.motorPowered = true;
        state.motorReady = false;
        state.targetPosition = -1;
        state.finalVelocityApplied = false;
        state.lastActivityTime = millis();
        state.isParked = false;
        state.homingState = HOMING_IDLE; // Achse war stromlos -> Homing neu ausführen
        log(F("Enabling motor"));
    }

    // Lazy Homing: Wenn Achse noch nicht (neu) gehomt wurde -> Homing jetzt starten
    if (state.homingState == HOMING_IDLE) {
        startSensorlessHoming();
        return false;
    }

    // Während Homing noch läuft -> weiter ausführen und alle Fahrbefehle blockieren
    if (state.homingState != HOMING_DONE) {
        if (state.homingState != HOMING_FAILED) {
            updateHoming();
        }
        return false;
    }

    state.motorReady = true;
    return true;
}

void AxisUnit::disableMotor() {
    if (state.motorPowered) {
        if (stepper != nullptr) {
            stepper->forceStop();
            stepper->disableOutputs();
        }
        isv57.disableAxis();
        state.motorPowered = false;
        state.motorReady = false;
        state.targetPosition = -1;
        state.finalVelocityApplied = false;
        state.isParked = false;
        state.homingState = HOMING_IDLE; // Homing-Status zurücksetzen für nächsten Wake-up
        log(F("Disabling motor"));
    }
    state.firstActivityTime = 0;
}

void AxisUnit::startSensorlessHoming() {
    log(F("Starting stepper calibration"));
    isv57.enableAxis();
    if (stepper != nullptr) {
        stepper->enableOutputs();
    }
    state.motorPowered = true;
    state.homingState = HOMING_START;
    state.motorReady = false;
    state.homingStateStartTime = millis();
}

void AxisUnit::updateHoming() {
    if (stepper == nullptr) return;

    switch (state.homingState) {
        case HOMING_IDLE:
        case HOMING_DONE:
        case HOMING_FAILED:
            break;

        case HOMING_START:
            isv57.enableAxis();
            stepper->enableOutputs();
            state.motorPowered = true;
            stepper->setSpeedInHz(settings.homingSpeed);
            stepper->setAcceleration(settings.homingAccel);
            stepper->applySpeedAcceleration();
            state.homingState = HOMING_WAIT_SERVO;
            state.homingStateStartTime = millis();
            break;

        case HOMING_WAIT_SERVO:
            if (servoInitialized && isv57.dynamicStates.servo_receivedPacketIsValid_b) {
                if (millis() - state.homingStateStartTime > 300) {
                    // Step 1: Move backward to find mechanical MIN hard stop
                    stepper->setSpeedInHz(settings.homingSpeed);
                    stepper->setAcceleration(settings.homingAccel);
                    stepper->applySpeedAcceleration();
                    stepper->runBackward();
                    state.homingState = HOMING_APPROACH_MIN;
                    state.homingStateStartTime = millis();
                    log(F("Starting calibration"));
                }
            } else if (millis() - state.homingStateStartTime > 15000) {
                // Timeout after 15s if servo power supply is off
                log(F("Servo communication timeout. Calibration aborted."));
                stepper->forceStop();
                state.homingState = HOMING_FAILED;
                state.motorReady = false;
            }
            break;

        case HOMING_APPROACH_MIN: {
            int16_t currentLoad = abs(isv57.dynamicStates.servo_current_percent);
            bool stallDetected = (currentLoad >= settings.homingCurrentThreshold);

            // Timeout failsafe (25s)
            if (millis() - state.homingStateStartTime > 25000) {
                stepper->forceStop();
                state.homingState = HOMING_FAILED;
                state.motorReady = false;
                break;
            }

            if (stallDetected) {
                stepper->forceStopAndNewPosition(-settings.homingBackoffSteps);
                stepper->moveTo(0);
                state.homingState = HOMING_BACKOFF_MIN;
            }
            break;
        }

        case HOMING_BACKOFF_MIN:
            if (!stepper->isRunning()) {
                // Set home zero position
                stepper->setCurrentPosition(0);
                isv57.setZeroPos();
                hardLimitMin = 0;

                if (settings.measureMaxTravel) {
                    // Step 2: Move forward to find mechanical MAX hard stop
                    stepper->setSpeedInHz(settings.homingSpeed);
                    stepper->setAcceleration(settings.homingAccel);
                    stepper->applySpeedAcceleration();
                    stepper->runForward();
                    state.homingState = HOMING_MEASURE_MAX_APPROACH;
                    state.homingStateStartTime = millis();
                } else {
                    // Single-endstop homing: assume configured working range
                    hardLimitMax = settings.totalWorkingRange;
                    float idlePct = settings.invertTensionDir ? (100.0f - IDLE_POSITION_PCT) : IDLE_POSITION_PCT;
                    int32_t targetIdle = (int32_t)((idlePct / 100.0f) * (float)hardLimitMax);
                    stepper->setSpeedInHz(settings.homingSpeed);
                    stepper->setAcceleration(settings.homingAccel);
                    stepper->applySpeedAcceleration();
                    stepper->moveTo(targetIdle);
                    state.homingState = HOMING_RETURN_HOME;
                }
            }
            break;

        case HOMING_MEASURE_MAX_APPROACH: {
            int16_t currentLoad = abs(isv57.dynamicStates.servo_current_percent);
            int32_t stepPos = stepper->getCurrentPosition();
            // Ignore stall check for the first HOMING_MIN_TRAVEL_MM to clear the MIN backoff region
            bool stallDetected = (stepPos > settings.homingMinTravelSteps) && (currentLoad >= settings.homingCurrentThreshold);

            // Timeout failsafe (25s)
            if (millis() - state.homingStateStartTime > 25000) {
                stepper->forceStop();
                hardLimitMax = settings.totalWorkingRange;
                state.homingState = HOMING_MEASURE_MAX_BACKOFF;
                break;
            }

            if (stallDetected) {
                int32_t measured = stepper->getCurrentPosition();
                hardLimitMax = measured - settings.homingBackoffSteps;
                if (hardLimitMax < settings.homingMinTravelSteps) {
                    hardLimitMax = settings.totalWorkingRange;
                }
                settings.totalWorkingRange = hardLimitMax;

                // Back off from MAX hard stop
                stepper->forceStopAndNewPosition(measured);
                stepper->moveTo(hardLimitMax);
                state.homingState = HOMING_MEASURE_MAX_BACKOFF;
            }
            break;
        }

        case HOMING_MEASURE_MAX_BACKOFF:
            if (!stepper->isRunning()) {
                // Step 3: Move to relaxed park position
                float idlePct = settings.invertTensionDir ? (100.0f - IDLE_POSITION_PCT) : IDLE_POSITION_PCT;
                int32_t targetIdle = (int32_t)((idlePct / 100.0f) * (float)hardLimitMax);
                stepper->setSpeedInHz(settings.homingSpeed);
                stepper->setAcceleration(settings.homingAccel);
                stepper->applySpeedAcceleration();
                stepper->moveTo(targetIdle);
                state.homingState = HOMING_RETURN_HOME;
            }
            break;

        case HOMING_RETURN_HOME:
            if (!stepper->isRunning()) {
                // Homing completely finished! Restore normal high speed
                stepper->setSpeedInHz(settings.maxSpeed);
                stepper->setAcceleration(settings.acceleration);
                stepper->applySpeedAcceleration();
                state.homingState = HOMING_DONE;
                state.motorReady = true;
                log(F("Calibration successful."));

                // Flush any stale telemetry packets accumulated during the homing sequence
                while (Serial.available()) {
                    Serial.read();
                }
            }
            break;
    }
}

void AxisUnit::setPosition16Bits(uint16_t inputPosition) {
    int32_t newPosition = convertPosition16Bits(inputPosition);

    if (enableMotor()) {
        state.lastActivityTime = millis();
        state.isParked = false;

        if (!state.finalVelocityApplied) {
            stepper->setSpeedInHz(settings.maxSpeed);
            stepper->setAcceleration(settings.acceleration);
            stepper->applySpeedAcceleration();
            state.finalVelocityApplied = true;
        }

        if (newPosition != state.targetPosition) {
            state.targetPosition = newPosition;
            stepper->moveTo(newPosition);
        }
    }
}

void AxisUnit::setMaxSpeed16Bits(uint16_t speed) {
    if (speed > 0) {
        settings.maxSpeedMS = (float)speed * SPEED_MULTIPLIER;
        applyMotionUnits();
        if (stepper != nullptr && state.motorReady) {
            stepper->setSpeedInHz(settings.maxSpeed);
            stepper->applySpeedAcceleration();
        }
        state.finalVelocityApplied = false;
    }
}

void AxisUnit::setMaxAcceleration32Bits(uint32_t accel) {
    if (accel > 0) {
        settings.accelerationMS2 = (float)accel * ACCELERATION_MULTIPLIER;
        applyMotionUnits();
        if (stepper != nullptr && state.motorReady) {
            stepper->setAcceleration(settings.acceleration);
            stepper->applySpeedAcceleration();
        }
        state.finalVelocityApplied = false;
    }
}

void AxisUnit::moveToIdle(bool blocking) {
    if (stepper == nullptr) return;

    stepper->setSpeedInHz(settings.homingSpeed);
    stepper->setAcceleration(settings.homingAccel);
    stepper->applySpeedAcceleration();
    // Force the next position command to restore full drive speed/acceleration
    state.finalVelocityApplied = false;

    // Park at relaxed position (10% or 90% depending on invertTensionDir)
    float idlePct = settings.invertTensionDir ? (100.0f - IDLE_POSITION_PCT) : IDLE_POSITION_PCT;
    int32_t idlePos = (int32_t)((idlePct / 100.0f) * (float)hardLimitMax);
    stepper->moveTo(idlePos);

    if (blocking) {
        while (stepper->isRunning()) {
            delay(1);
        }
    }
}

void AxisUnit::updateIdleWatchdog(unsigned long idleTimeoutMs) {
    // 1. Perform continuous step-loss position correction when at standstill
    correctPos();

    if (state.homingState != HOMING_DONE && state.homingState != HOMING_IDLE) {
        updateHoming();
        return;
    }

    if (state.motorPowered) {
        if (millis() - state.lastActivityTime > idleTimeoutMs) {
            if (!state.isParked) {
                state.firstActivityTime = 0;
                moveToIdle(false);
                state.isParked = true;
            } else if (stepper == nullptr || !stepper->isRunning()) {
                // Once motor reached relaxed idle park position and is at standstill, disable servo axis
                disableMotor();
            }
        }
    }
}

int32_t AxisUnit::getCurrentPosition() const {
    return (stepper != nullptr) ? stepper->getCurrentPosition() : 0;
}

bool AxisUnit::flashTunedParameters(Stream* logStream) {
    isFlashing = true;
    delay(100); // Give background task time to finish any in-flight Modbus packet
    log(F("Starting servo EEPROM flash..."));
    bool ok = isv57.flashTunedParameters(settings.invertDir, STEPS_PER_MOTOR_REV, logStream);
    if (ok) {
        log(F("Servo EEPROM flash successful!"));
    } else {
        log(F("Servo EEPROM flash failed!"));
    }
    isFlashing = false;
    return ok;
}

void AxisUnit::dumpServoParameters(bool onlyDiff, Stream* logStream) {
    isReadingParams = true;
    delay(100); // Give background task time to finish any in-flight Modbus packet
    isv57.dumpParameters(STEPS_PER_MOTOR_REV, onlyDiff, logStream);
    isReadingParams = false;
}
