ChrGri/DIY-Sim-Racing-FFB-BeltTensioner/src/isv57communication.cpp

#include "isv57communication.h"
#include "isv57_tunedParameters.h"
#include <Arduino.h>

// Default motor ratings from the tuned parameter table, replaced by readMotorRatings()
static Isv57MotorRatings defaultMotorRatings() {
    Isv57MotorRatings ratings;
    ratings.ratedSpeedRpm = (int16_t)isv57_tuned_parameters[pr_7_00 + 10];
    ratings.ratedCurrent0p01A = (int16_t)isv57_tuned_parameters[pr_7_00 + 12];
    ratings.ratedPowerW = (int16_t)isv57_tuned_parameters[pr_7_00 + 14];
    ratings.readFromServo = false;
    return ratings;
}

Isv57Communication::Isv57Communication() {
    this->slaveId = 63;
    this->motorRatings = defaultMotorRatings();
}

Isv57Communication::Isv57Communication(HardwareSerial* serial, int16_t defaultSlaveId) {
    this->slaveId = defaultSlaveId;
    this->modbus.setSerial(serial);
    this->motorRatings = defaultMotorRatings();
}

void Isv57Communication::setSerial(HardwareSerial* serial, int16_t defaultSlaveId) {
    this->slaveId = defaultSlaveId;
    this->modbus.setSerial(serial);
}

bool Isv57Communication::initialize(int32_t baudrate, int8_t rxPin, int8_t txPin, bool invertSignal) {
    this->modbus.setSerialTimeout(60);
    return this->modbus.initialize(baudrate, rxPin, txPin, false, invertSignal);
}

void Isv57Communication::setupServoStateReading() {
    modbus.writeAndVerifyDeviceParameter(slaveId, 0x0191, reg_add_position_given_p);
    modbus.writeAndVerifyDeviceParameter(slaveId, 0x0192, reg_add_velocity_current_feedback_percent);
    modbus.writeAndVerifyDeviceParameter(slaveId, 0x0193, reg_add_position_error_p);
    modbus.writeAndVerifyDeviceParameter(slaveId, 0x0194, reg_add_voltage_0p1V);
}

void Isv57Communication::sendTunedServoParameters(bool commandRotationDirection, uint32_t stepsPerMotorRev_u32) {
    modbus.writeAndVerifyDeviceParameter(slaveId, pr_0_00 + 6, commandRotationDirection ? 1 : 0);
    modbus.writeAndVerifyDeviceParameter(slaveId, pr_0_00 + 8, (long)stepsPerMotorRev_u32);
    modbus.writeAndVerifyDeviceParameter(slaveId, pr_1_00 + 37, 1052); // Alarm mask
}

// Per-unit factory calibration values that must not be copied from one servo to another
static bool isUnitSpecificParam(uint16_t regIdx) {
    return regIdx == (pr_7_00 + 18); // Pr7.18: Encoder index angle compensation
}

bool Isv57Communication::flashTunedParameters(bool commandRotationDirection, uint32_t stepsPerMotorRev_u32, Stream* logStream) {
    if (logStream != nullptr) {
        logStream->println(F("=================================================="));
        logStream->print(F("Flashing tuned parameters to servo (Slave ID "));
        logStream->print(slaveId);
        logStream->println(F(")..."));
        logStream->println(F("=================================================="));
    }

    uint16_t updatedCount = 0;
    uint16_t matchedCount = 0;

    for (uint16_t regIdx = 0; regIdx < ISV57_TUNED_PARAM_COUNT; regIdx++) {
        if (isUnitSpecificParam(regIdx)) continue;
        int32_t targetVal = isv57_tuned_parameters[regIdx];

        // Apply motor-specific config overrides
        if (regIdx == (pr_0_00 + 8)) {
            targetVal = (int32_t)stepsPerMotorRev_u32;
        }

        bool wasWritten = modbus.writeAndVerifyDeviceParameter(slaveId, regIdx, targetVal);
        if (wasWritten) {
            updatedCount++;
            if (logStream != nullptr) {
                logStream->print(F("[Flash] Reg 0x"));
                if (regIdx < 0x10) logStream->print(F("000"));
                else if (regIdx < 0x100) logStream->print(F("00"));
                else if (regIdx < 0x1000) logStream->print(F("0"));
                logStream->print(regIdx, HEX);
                logStream->print(F(" -> Updated to "));
                logStream->println(targetVal);
            }
        } else {
            matchedCount++;
        }

        // Print progress milestone every 30 registers
        if ((regIdx + 1) % 30 == 0 || regIdx == (ISV57_TUNED_PARAM_COUNT - 1)) {
            if (logStream != nullptr) {
                logStream->print(F("[Flash] Progress: "));
                logStream->print(regIdx + 1);
                logStream->print(F("/"));
                logStream->print(ISV57_TUNED_PARAM_COUNT);
                logStream->println(F(" registers verified."));
            }
        }
    }

    delay(50);
    // Command 0x019A = 0x5555 persists all parameters permanently into the iSV57 EEPROM / NVM
    int32_t nvmRes = modbus.writeHoldingRegisterToDevice(slaveId, 0x019A, 0x5555);
    delay(500);

    if (logStream != nullptr) {
        logStream->println(F("--------------------------------------------------"));
        logStream->print(F("[Flash] Summary: "));
        logStream->print(updatedCount);
        logStream->print(F(" registers written/updated, "));
        logStream->print(matchedCount);
        logStream->println(F(" already matched."));
        if (nvmRes > 0) {
            logStream->println(F("[Flash] Successfully saved parameters to servo EEPROM (0x5555)!"));
            logStream->println(F("[Flash] Done! Please power cycle the servo to activate all new gains."));
        } else {
            logStream->println(F("[Flash] Warning: NVM save command (0x5555) did not receive ACK."));
        }
        logStream->println(F("=================================================="));
    }
    return (nvmRes > 0);
}

// Parameter group start addresses (Pr0.xx ... Pr7.xx)
static const uint16_t s_paramGroupStart_au16[] = {
    0x0000, 0x0019, 0x0041, 0x005F, 0x007D, 0x00AF, 0x00D7, 0x00FF
};

static void printParamLabel(Stream* logStream, uint16_t regIdx) {
    uint8_t group = 0;
    for (uint8_t g = 0; g < sizeof(s_paramGroupStart_au16) / sizeof(s_paramGroupStart_au16[0]); g++) {
        if (regIdx >= s_paramGroupStart_au16[g]) {
            group = g;
        }
    }
    uint16_t subIdx = regIdx - s_paramGroupStart_au16[group];
    char label[24];
    snprintf(label, sizeof(label), "Pr%u.%02u (0x%04X)", group, subIdx, regIdx);
    logStream->print(label);
}

// Read-only: reads all tuned-table parameters from the servo and compares them with the tuned values.
// onlyDiff = true prints deviating registers only. Returns the number of deviating registers.
uint16_t Isv57Communication::dumpParameters(uint32_t stepsPerMotorRev_u32, bool onlyDiff, Stream* logStream) {
    if (logStream == nullptr) return 0;

    logStream->println(F("=================================================="));
    if (onlyDiff) {
        logStream->print(F("Servo parameters differing from tuned table (Slave ID "));
    } else {
        logStream->print(F("Servo parameters (Slave ID "));
    }
    logStream->print(slaveId);
    logStream->println(F(")"));
    logStream->println(F("=================================================="));

    uint16_t diffCount = 0;
    uint16_t errorCount = 0;

    for (uint16_t regIdx = 0; regIdx < ISV57_TUNED_PARAM_COUNT; regIdx++) {
        bool unitSpecific = isUnitSpecificParam(regIdx);
        if (onlyDiff && unitSpecific) continue;
        int32_t tunedVal = isv57_tuned_parameters[regIdx];
        if (regIdx == (pr_0_00 + 8)) {
            tunedVal = (int32_t)stepsPerMotorRev_u32;
        }

        int16_t actualVal = 0;
        bool readOk = false;
        for (uint8_t tryIndex_u8 = 0; tryIndex_u8 < 3 && !readOk; tryIndex_u8++) {
            readOk = (readRegisters(regIdx, 1, &actualVal) == 1);
        }

        if (!readOk) {
            errorCount++;
            printParamLabel(logStream, regIdx);
            logStream->println(F("  read error"));
            continue;
        }

        bool differs = !unitSpecific && ((int32_t)actualVal != tunedVal);
        if (differs) {
            diffCount++;
        }

        if (!onlyDiff || differs) {
            printParamLabel(logStream, regIdx);
            logStream->print(F("  actual: "));
            logStream->print(actualVal);
            if (unitSpecific) {
                logStream->print(F("  (unit-specific, not compared)"));
            } else {
                logStream->print(F("  tuned: "));
                logStream->print(tunedVal);
            }
            if (differs) {
                logStream->print(F("  <-- differs"));
            }
            logStream->println();
        }
    }

    logStream->println(F("--------------------------------------------------"));
    logStream->print(F("Summary: "));
    logStream->print(ISV57_TUNED_PARAM_COUNT);
    logStream->print(F(" registers, "));
    logStream->print(diffCount);
    logStream->print(F(" differ, "));
    logStream->print(errorCount);
    logStream->println(F(" read errors."));
    logStream->println(F("=================================================="));
    return diffCount;
}

void Isv57Communication::readServoStates() {
    for (uint8_t i = 0; i < NUMBER_OF_ISV57_REGISTERS_TO_READ_IN_CYCLIC_READ; i++) {
        regArray[i] = -1;
    }

    int8_t numberOfRegisters = NUMBER_OF_ISV57_REGISTERS_TO_READ_IN_CYCLIC_READ;
    int bytesReceived = modbus.sendRequestAndReceiveResponse(slaveId, 0x03, ref_cyclic_read_0, numberOfRegisters);

    dynamicStates.servo_receivedPacketIsValid_b = false;

    if (bytesReceived == (numberOfRegisters * 2)) {
        modbus.getRawRxBuffer(raw, len);
        for (uint8_t regIdx = 0; regIdx < numberOfRegisters; regIdx++) {
            regArray[regIdx] = modbus.convertRxBufferToInt16(regIdx);
        }

        dynamicStates.servo_pos_given_p = regArray[0];
        dynamicStates.servo_current_percent = regArray[1];
        dynamicStates.servo_pos_error_p = regArray[2];
        dynamicStates.servoVoltage0p1V_i16 = regArray[3];

        dynamicStates.lastUpdateTimeInMS_u32 = millis();
        dynamicStates.servo_cycleCounter_u32++;
        dynamicStates.servo_receivedPacketIsValid_b = (dynamicStates.servoVoltage0p1V_i16 >= 50);
    }
}

bool Isv57Communication::readMotorRatings() {
    // Pr7.10 ... Pr7.14 in one request: rated speed, max speed, rated current, rotor inertia, power
    int16_t regs[5] = {0};
    if (readRegisters(pr_7_00 + 10, 5, regs) != 5) return false;
    if (regs[0] <= 0 || regs[2] <= 0 || regs[4] <= 0) return false;

    Isv57MotorRatings ratings;
    ratings.ratedSpeedRpm = regs[0];
    ratings.ratedCurrent0p01A = regs[2];
    ratings.ratedPowerW = regs[4];
    ratings.readFromServo = true;
    motorRatings = ratings;
    return true;
}

bool Isv57Communication::checkCommunication() {
    return (modbus.sendRequestAndReceiveResponse(slaveId, 0x03, 0x0000, 2) > 0);
}

bool Isv57Communication::findServosSlaveId() {
    if (checkCommunication()) {
        return true;
    }

    int commonIds[] = {63, 1, 2, 0, 3, 4, 5};
    for (int id : commonIds) {
        if (modbus.sendRequestAndReceiveResponse(id, 0x03, 0x0000, 2) > 0) {
            slaveId = (int16_t)id;
            return true;
        }
        delay(2);
    }

    return false;
}

bool Isv57Communication::clearServoAlarms() {
    return (modbus.writeHoldingRegisterToDevice(slaveId, 0x019A, 0x1111) > 0);
}

void Isv57Communication::disableAxis() {
    modbus.writeHoldingRegisterToDevice(slaveId, 0x0085, 0x0303);
    modbus.writeHoldingRegisterToDevice(slaveId, 0x0139, 0x0000);
    delay(30);
    modbus.readHoldingRegisterFromDevice(slaveId, 0x0085);
    modbus.readHoldingRegisterFromDevice(slaveId, 0x0139);
    delay(5);
}

void Isv57Communication::enableAxis() {
    modbus.writeHoldingRegisterToDevice(slaveId, 0x0085, 0x0383);
    modbus.writeHoldingRegisterToDevice(slaveId, 0x0139, 0x0008);
    delay(30);
    modbus.readHoldingRegisterFromDevice(slaveId, 0x0085);
    modbus.readHoldingRegisterFromDevice(slaveId, 0x0139);
    delay(5);
}

void Isv57Communication::clearServoUnitPosition() {
    modbus.writeAndVerifyDeviceParameter(slaveId, pr_5_00 + 20, 0);
    delay(20);
    modbus.writeAndVerifyDeviceParameter(slaveId, pr_5_00 + 20, 1);
    delay(20);
}

bool Isv57Communication::setServoVoltage(uint16_t voltageInVolt_u16) {
    return modbus.writeAndVerifyDeviceParameter(slaveId, pr_7_00 + 32, voltageInVolt_u16 + 2);
}

bool Isv57Communication::setPositionSmoothingFactor(uint16_t posSmoothingFactor_u16) {
    return modbus.writeAndVerifyDeviceParameter(slaveId, pr_2_00 + 22, posSmoothingFactor_u16);
}

void Isv57Communication::setZeroPos() {
    zeroPos = dynamicStates.servo_pos_given_p;
}

int Isv57Communication::readRegisters(uint16_t startAddr_u16, uint8_t count_u8, int16_t* out_pi16) {
    if (count_u8 == 0 || out_pi16 == nullptr) return -1;
    int bytes = modbus.sendRequestAndReceiveResponse(slaveId, 0x03, startAddr_u16, count_u8);
    if (bytes == count_u8 * 2) {
        for (uint8_t i = 0; i < count_u8; i++) {
            out_pi16[i] = modbus.convertRxBufferToInt16(i);
        }
        return count_u8;
    }
    return -1;
}

int32_t Isv57Communication::writeHoldingRegisterToDevice(int32_t slaveId_i32, int32_t registerAddress_i32, uint16_t value_u16) {
    return modbus.writeHoldingRegisterToDevice(slaveId_i32, registerAddress_i32, value_u16);
}

int32_t Isv57Communication::writeHoldingRegistersToDevice(int32_t slaveId_i32, int32_t registerAddress_i32, const uint16_t* values_u16, uint8_t count_u8) {
    return modbus.writeHoldingRegistersToDevice(slaveId_i32, registerAddress_i32, values_u16, count_u8);
}
