ChrGri/DIY-Sim-Racing-FFB-BeltTensioner/src/AxisUnit.h

#pragma once

#include <Arduino.h>
#include <FastAccelStepper.h>
#include "isv57communication.h"
#include "AxisConfig.h"
#include "Config.h"

enum HomingState {
    HOMING_IDLE,
    HOMING_START,
    HOMING_WAIT_SERVO,
    HOMING_APPROACH_MIN,
    HOMING_BACKOFF_MIN,
    HOMING_MEASURE_MAX_APPROACH,
    HOMING_MEASURE_MAX_BACKOFF,
    HOMING_RETURN_HOME,
    HOMING_DONE,
    HOMING_FAILED
};

struct AxisUnitSettings {
    uint8_t stepperId = 1;
    int8_t stepPin = -1;
    int8_t dirPin = -1;
    int8_t enaPin = -1;
    int8_t almPin = -1;
    int8_t brakeResistorPin = -1;
    bool invertDir = false;
    bool invertTensionDir = INVERT_TENSION_DIRECTION;
    bool enableStepLossRecov = ENABLE_STEP_LOSS_RECOVERY;
    AxisMechConfig mech; // Spindle pitch & working range in mm (from NVS or Config.h)
    int32_t totalWorkingRange = TOTAL_WORKING_RANGE_STEPS;
    uint8_t homingCurrentThreshold = HOMING_CURRENT_THRESHOLD_PCT;
    bool centerAfterCalib = CENTER_AFTER_CALIBRATION;
    bool measureMaxTravel = MEASURE_MAX_TRAVEL_SENSORLESS;

    // Motion in carriage units: identical for all axes regardless of spindle pitch
    float maxSpeedMS = DEFAULT_MAX_SPEED_M_S;
    float accelerationMS2 = DEFAULT_ACCELERATION_M_S2;
    float homingSpeedMS = HOMING_SPEED_M_S;
    float homingAccelMS2 = HOMING_ACCELERATION_M_S2;
    float homingBackoffMm = HOMING_BACKOFF_MM;

    // Derived step values for this axis' pitch (computed by AxisUnit::applyMotionUnits())
    uint32_t maxSpeed = 0;           // steps/s
    uint32_t acceleration = 0;       // steps/s^2
    uint32_t homingSpeed = 0;        // steps/s
    uint32_t homingAccel = 0;        // steps/s^2
    int32_t homingBackoffSteps = 0;  // steps
    int32_t homingMinTravelSteps = 0; // steps
};

struct AxisUnitState {
    bool motorPowered = false;
    bool motorReady = false;
    int32_t targetPosition = -1;
    unsigned long lastActivityTime = 0;
    unsigned long firstActivityTime = 0;
    bool isParked = false;
    bool finalVelocityApplied = false;
    HomingState homingState = HOMING_IDLE;
    uint32_t homingStateStartTime = 0;
};

class AxisUnit {
public:
    AxisUnitSettings settings;
    AxisUnitState state;
    Isv57Communication isv57;

    // Step Loss Recovery variables (lockless 32-bit atomic on ESP32-S3)
    volatile int32_t servo_offset_compensation_steps_i32 = 0;
    int32_t servoPosCorrected_i32 = 0;
    volatile bool servoInitialized = false;
    volatile bool isFlashing = false;
    volatile bool isReadingParams = false;

    AxisUnit();

    bool begin(FastAccelStepperEngine* engine,
               const AxisUnitSettings& axisSettings,
               HardwareSerial* serial,
               int8_t rxPin,
               int8_t txPin,
               int16_t slaveId,
               bool calibrateAtBoot = true,
               bool invertModbusSignal = false);

    void setPosition16Bits(uint16_t inputPosition);
    void setMaxSpeed16Bits(uint16_t speed);
    void setMaxAcceleration32Bits(uint32_t accel);

    void startSensorlessHoming();
    void updateHoming();
    void updateIdleWatchdog(unsigned long idleTimeoutMs);
    void moveToIdle(bool blocking = false);

    bool enableMotor();
    void disableMotor();
    bool flashTunedParameters(Stream* logStream = nullptr);
    void dumpServoParameters(bool onlyDiff, Stream* logStream);

    void pollModbusTelemetry();
    void unwrapAndCalculateStepLoss();
    void correctPos();
    void printStatus();

    bool isHomed() const { return state.homingState == HOMING_DONE; }
    bool isMotorReady() const { return state.motorReady; }
    int32_t getCurrentPosition() const;
    int32_t getCurrentSpeedHz() const { return (stepper != nullptr) ? stepper->getCurrentSpeedInMilliHz() / 1000 : 0; }
    int16_t getCurrentLoadPercent() const { return isv57.dynamicStates.servo_current_percent; }
    float getBusVoltage() const { return ((float)isv57.dynamicStates.servoVoltage0p1V_i16) * 0.1f; }
    int32_t getWorkingRange() const { return hardLimitMax; }

    int32_t convertPosition16Bits(uint16_t inputPosition) const {
        int32_t minPos = (int32_t)((MIN_SAFETY_LIMIT_PCT / 100.0f) * (float)hardLimitMax);
        int32_t maxPos = (int32_t)((MAX_SAFETY_LIMIT_PCT / 100.0f) * (float)hardLimitMax);
        int32_t target;
        if (settings.invertTensionDir) {
            // Inverted: 0 input (idle/no brake) -> maxPos (relaxed), 65535 input (full brake) -> minPos (pulled tight)
            target = maxPos - (int32_t)(((uint64_t)inputPosition * (uint64_t)(maxPos - minPos)) / 65535ULL);
        } else {
            // Normal: 0 input (idle/no brake) -> minPos (relaxed), 65535 input (full brake) -> maxPos (pulled tight)
            target = minPos + (int32_t)(((uint64_t)inputPosition * (uint64_t)(maxPos - minPos)) / 65535ULL);
        }
        return constrain(target, minPos, maxPos);
    }

private:
    FastAccelStepper* stepper = nullptr;
    String logHeader;
    int32_t hardLimitMin = 0;
    int32_t hardLimitMax = TOTAL_WORKING_RANGE_STEPS;

    void log(const String& msg);
    // Converts the m/s and m/s^2 settings into step rates for this axis' spindle pitch
    void applyMotionUnits();
    uint32_t toStepRate(float metersPerSecond) const;
};
