ChrGri/DIY-Sim-Racing-FFB-BeltTensioner/(commit log)

2026-08-23 Added video of belt tensioner working
2026-09-01 Added youtube video link, thumbnails, BOM, instructions
2026-09-18 Added V2 PCBA
    [partition_4M_customized.csv]
2026-10-10 Fix sluggish response after idle park; clamp brake resistor pin early
    - moveToIdle() switched the stepper to homing speed/acceleration but left
    finalVelocityApplied set, so a position command arriving during the park
    move kept running at homing dynamics until SimHub resent CMD 2/3.
    - Drive the brake resistor pins LOW in the early pin-clamp block of setup()
    instead of only in AxisUnit::begin().
2026-10-10 Add ControlBoard_V4, V5 and PCBA V1X build environments
    - New PlatformIO envs ControlBoard_V4 (PCB 6), ControlBoard_V5_without_espnow
    (PCB 12) and ControlBoard_PCBA_V1X (PCB 7) with pin maps ported from the
    DIY FFB Pedal firmware.
    - Support inverted servo UART signal (ACTUATORx_MODBUS_INVERT) as required
    by PCB 6 and 7; TX pin idles LOW on inverted boards.
    - Add new envs to the CI build matrix.
    - Document pinouts, LEDs and release archives for the new boards and
    describe the README as supporting all ESP32-S3 ControlBoards.
2026-10-11 Report native-USB boards as "diy_belt_tensioner"
    Switch ControlBoard_V7, PCBA_V1X and PCBA_V2X from the fixed-name
    USB-Serial/JTAG peripheral to TinyUSB CDC (ARDUINO_USB_MODE=0) so the
    USB product string can be set to "diy_belt_tensioner" (manufacturer
    "OpenSource", as in the FFB pedal firmware). V7 now also uses the
    1200bps touch for uploads.
2026-10-14 Add DUMP_SERVO/DIFF_SERVO commands and align servo table with V6 servo
    - New read-only serial commands DUMP_SERVO (list all 305 servo parameters)
    and DIFF_SERVO (list only parameters differing from the tuned table).
    - Update isv57_tunedParameters.h to the values of the working V6 belt
    tensioner servo, most importantly Pr0.06 = 1 (rotation direction), which
    fixes homing in the wrong direction after FLASH_SERVO.
    - Skip the unit-specific Pr7.18 (encoder index angle compensation) when
    flashing and comparing, so it is never copied between servos.
2026-10-14 Document servo register flashing, Motion licence and dual belt setup
    - Firmware_Flashing.md: new required Step 7 (FLASH_SERVO via serial
    monitor) with screenshot; list all supported boards.
    - SimHub_Motion_Setup.md: Motion addon licence requirement with
    screenshot, single/dual presets (replacing AllPlatformSettings), and
    dual belt tensioner axis mapping with one axis per actuator.
2026-10-21 Add CAD source models and SolidCraft assembly of the belt tensioner
    Fusion 360 sources with STEP exports of the 2040 holder, 4020 connector,
    JKK60 linear modules, ISV57T servos, Meanwell LRS-350 PSU and adapters,
    plus the full SolidCraft assembly (2040/2020 frame, rollers, seat distance
    holders, belt adapters with washers and M8 bolts).
2026-10-21 Add printable enclosure, PSU, servos and render to belt tensioner assembly
    - Mount Meanwell LRS-350 with two Lrs350To2040Adapter between the rails
    - Flange ISV57T-130S servos to both JKK60 modules, ports facing inward
    - Lengthen BeltToJkkAdapter to 31 mm, add M8x35 with six washers each
    - Extend RailTo4020Adapter into two back plates with M3 insert holes
    - Add four-part printable hood (3 mm wall, chamfered outer edges) with
    belt slots, PSU/servo vents, cable cutout and screwed joining tabs
    - Assign materials and add a rendered overview image
2026-10-21 Rework enclosure and add printable 3MF parts
    - Replace front vent slots with a hexagonal pattern on all hood segments
    - Use R5 fillets on the four depth edges of the hood
    - Close the side vent slots next to the servos
    - Add two lower back plates on the 2040 between the servos to fasten the
    hood bottom, and shrink the cable cutout
    - Export all printed parts as 3MF to cad/stl (quantity in file name)
    - Update the overview render
2026-10-21 Document dual channel mechanical design and refine enclosure
    - Add docs/Mechanical_Design_Dual_Channel.md with layout, housing concept,
    printed and purchased parts and assembly order
    - Reference the dual channel design, render, CAD files and 3MF parts in
    README (highlights, new section, quick setup, docs table) and BOM
    - Engrave SimRacing Science logo on both upper hood side walls
    - Round the hood inner long edges (R2) and back plate outer corners (R2)
    - Re-export hood and back plate 3MF files and update the render
2026-10-24 Increased length of lover cover by 5mm
2026-11-02 Add live web graphs, per-axis spindle config and m/s motion units
    Web graphs (ENABLE_WEBGRAPHS in Config.h):
    - WiFi starts at boot and serves a self-contained page with live graphs
    of position, target, servo encoder, current (A), mechanical power,
    bus voltage and following error, plus CSV export.
    - Access point "diy_belt_tensioner" by default; the local network can be
    set on the page (with scan) and is stored in NVS, falling back to the
    access point if it cannot be joined.
    - Never writes to Serial on its own so the SimHub handshake stays intact;
    the WEBGRAPHS command prints the address.
    - Motor ratings (Pr7.10 rated speed, Pr7.12 rated current, Pr7.14 power)
    are read from the ser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
2026-11-05 Add ControlBoard_V8 and SimHub support for native USB
    Add the V8 board (ESP32-S3-Zero, PCB_VERSION 15) with its pins, PlatformIO
    env, CI build and docs. The env uses the 4 MB partition table, because the
    board default is 8 MB and fails at boot on the S3-Zero.
    Make the SimHub Motion plugin connect over native USB. It opens the port with
    DTR low, which makes USBCDC drop all output, and it waits for the boot greeting
    before sending anything, which a board that does not reset on open cannot
    deliver. Replies now bypass the DTR check, and the greeting repeats until the
    host sends data. UART boards are unchanged.
2026-11-06 Add ControlBoard holder and belt spacers, update logo
    - Two ControlBoard V8 below the PSU on a printable PCB_Halter
    (25 deg angled, supports-free on its flat back, M3 inserts, M5 to 2040)
    - Replace the M8 washer stacks with printed 15 mm spacers with
    a 20 mm collar and use M8x40 bolts
    - Engrave the logo as "SimRacingScience"
    - Remove hidden servo and PCB internals from the assembly
    - Update the dual channel mechanical design guide
